kiwitea/esphome-louder-esp32-jukebox/static/index.md

# About

Kids Jukebox based on Louder-ESP32. Derived from https://github.com/XtracT/rfid_jukebox and the original Sonocotta project: https://github.com/sonocotta/esp32-audio-dock.

# Installation

You can use the button below to install the pre-built firmware directly to your device via USB from the browser.

<esp-web-install-button manifest="firmware/project-template.manifest.json"></esp-web-install-button>

<script type="module" src="https://unpkg.com/esp-web-tools@10/dist/web/install-button.js?module"></script>
