kiwitea/esphome-louder-esp32-jukebox/hardware/speakers/speaker_box_v5.stl

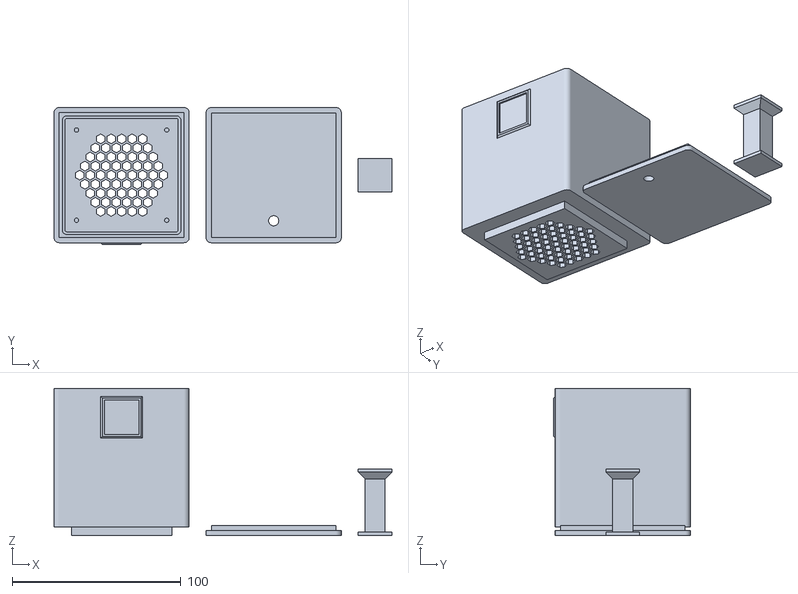
[picture p3: CAD file, 2026-11-13]
hardware/speakers/speaker_box_v5.stl
200.0 x 81.0 x 87.0
