kiwitea/esphome-louder-esp32-jukebox/(list of files, cad)

Other CAD files:
hardware/speakers/speaker_box_v4.scad
