kiwitea/esphome-louder-esp32-jukebox/(commit log)

2026-11-12 feat: add speaker box 3d model
    [speaker_box_v4.scad, speaker_box_v4.stl]
2026-11-13 feat: speaker enclosure v5
    [speaker_box_v4.stl, speaker_box_v5.scad, speaker_box_v5.stl]
